hyderhasnain/arduino_touchscreen_controller/Schematic And Design/Eagle Board Unrouted.brd

## EAGLE design Schematic And Design/Eagle Board Unrouted.brd (2014-02-13)

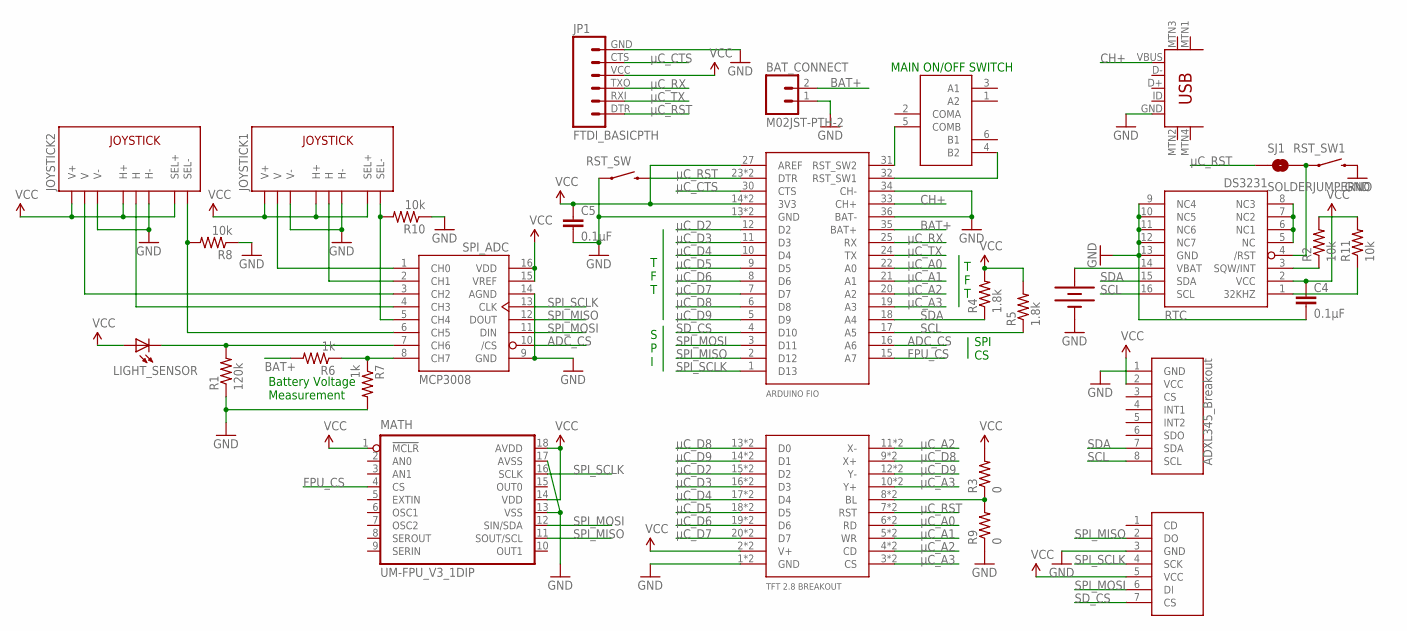
[picture p1: schematic Eagle Schematic.sch]

Parts:
ACCEL1: ADXL345_BREAKOUT; 1X08
BAT1: BATTERY12MM; BATTCON_12MM
BAT_CONNECT: M02JST-PTH-2; JST-2-PTH
C4, C5: 0.1µF; CAP-PTH-SMALL
JOYSTICK1, JOYSTICK2: JOYSTICKPTH; JOYSTICK
JP1: FTDI_BASICPTH; FTDI_BASIC
LIGHT_SENSOR: LED5MM
MATH: UM-FPU_V3_1DIP; DIL18
R1: 120k; AXIAL-0.4
R2, R8, R10, R11: 10k; AXIAL-0.4
R3, R9: 0; AXIAL-0.4
R4, R5: 1.8k; AXIAL-0.4
R6, R7: 1k; AXIAL-0.4
RST_SW, RST_SW1: SWITCH-MOMENTARY-2PTH; TACTILE-PTH
RTC: DS3231/SO; SO16W
SJ1: SOLDERJUMPERNO; SJ_2S-NO
SPI_ADC: MCP3008; DIL16
U$1: ARDUINOFIO
U$2: TFT2.8BREAKOUT
U$3: RIGHTANGLE_DPDT_PTH
U$4: MICROSD_BREAKOUT
USB_CHARGE: USB-MINIB-5PIN; USB-MINIB

Connections:
ADC_CS: SPI_ADC.10 (/CS), U$1.16 (A6)
BAT+: BAT_CONNECT.2, R6.P$2 (2), U$1.35 (BAT+)
CH+: U$1.33 (CH+), USB_CHARGE.VBUS
FPU_CS: MATH.4 (CS), U$1.15 (A7)
GND: ACCEL1.1 (GND), BAT1.GND (-), BAT_CONNECT.1, C4.2, C5.2, JOYSTICK1.H3 (H-), JOYSTICK1.V3 (V-), JOYSTICK2.H3 (H-), JOYSTICK2.V3 (V-), JP1.GND (6), MATH.13 (VSS), MATH.17 (AVSS), R1.P$1 (1), R7.P$2 (2), R8.P$1 (1), R9.P$1 (1), R10.P$1 (1), RST_SW.1, RST_SW1.3 (2), RTC.9 (NC4), RTC.10 (NC5), RTC.11 (NC6), RTC.12 (NC7), RTC.13 (GND), SPI_ADC.9 (GND), SPI_ADC.14 (AGND), U$1.13 (GND), U$1.28 (GND), U$1.34 (CH-), U$1.36 (BAT-), U$2.1 (GND), U$2.21 (GND), U$4.3 (GND), USB_CHARGE.GND
unnamed: JOYSTICK1.B2A (SEL-), R10.P$2 (2), SPI_ADC.5 (CH4)
unnamed: JOYSTICK2.B2A (SEL-), R8.P$2 (2), SPI_ADC.6 (CH5)
unnamed: LIGHT_SENSOR.K (C), R1.P$2 (2), SPI_ADC.7 (CH6)
unnamed: U$1.31 (RST_SW2), U$3.5 (COMB)
unnamed: U$1.32 (RST_SW1), U$3.4 (B2)
unnamed: RST_SW1.1, RTC.4 (/RST), SJ1.2
unnamed: R3.P$1 (1), R9.P$2 (2), U$2.8 (BL), U$2.34 (BL)
unnamed: R6.P$1 (1), R7.P$1 (1), SPI_ADC.8 (CH7)
unnamed: BAT1.PWR@1 (+), RTC.14 (VBAT)
unnamed: R2.P$1 (1), RTC.3 (SQW/INT)
unnamed: R11.P$1 (1), RTC.1 (32KHZ)
unnamed: R2.P$2 (2), R11.P$2 (2)
unnamed: JOYSTICK1.V2 (V), SPI_ADC.1 (CH0)
unnamed: JOYSTICK1.H2 (H), SPI_ADC.2 (CH1)
unnamed: JOYSTICK2.V2 (V), SPI_ADC.3 (CH2)
unnamed: JOYSTICK2.H2 (H), SPI_ADC.4 (CH3)
unnamed: RTC.5 (NC), RTC.6 (NC1), RTC.7 (NC2), RTC.8 (NC3)
SCL: ACCEL1.8 (SCL), R5.P$1 (1), RTC.16 (SCL), U$1.17 (A5)
SDA: ACCEL1.7 (SDA), R4.P$1 (1), RTC.15 (SDA), U$1.18 (A4)
SD_CS: U$1.4 (D10), U$4.7 (CS)
SPI_MISO: MATH.11 (SOUT/SCL), SPI_ADC.12 (DOUT), U$1.2 (D12), U$4.2 (DO)
SPI_MOSI: MATH.12 (SIN/SDA), SPI_ADC.11 (DIN), U$1.3 (D11), U$4.6 (DI)
SPI_SCLK: MATH.16 (SCLK), SPI_ADC.13 (CLK), U$1.1 (D13), U$4.4 (SCK)
VCC: ACCEL1.2 (VCC), C4.1, C5.1, JOYSTICK1.B1A (SEL+), JOYSTICK1.H1 (H+), JOYSTICK1.V1 (V+), JOYSTICK2.B1A (SEL+), JOYSTICK2.H1 (H+), JOYSTICK2.V1 (V+), JP1.VCC (4), LIGHT_SENSOR.A, MATH.1 (!MCLR), MATH.14 (VDD), MATH.18 (AVDD), R3.P$2 (2), R4.P$2 (2), R5.P$2 (2), RTC.2 (VCC), SPI_ADC.15 (VREF), SPI_ADC.16 (VDD), U$1.14 (3V3), U$1.26 (3V3), U$1.27 (AREF), U$2.2 (V+), U$2.31 (V+), U$4.5 (VCC)
µC_A0: U$1.22 (A0), U$2.6 (RD), U$2.33 (RD)
µC_A1: U$1.21 (A1), U$2.5 (WR), U$2.23 (WR)
µC_A2: U$1.20 (A2), U$2.4 (CD), U$2.11 (X-), U$2.26 (X-), U$2.32 (CD)
µC_A3: U$1.19 (A3), U$2.3 (CS), U$2.10 (Y+), U$2.22 (CS), U$2.35 (Y+)
µC_CTS: JP1.CTS (5), U$1.30 (CTS)
µC_D2: U$1.12 (D2), U$2.15 (D2), U$2.28 (D2)
µC_D3: U$1.11 (D3), U$2.16 (D3), U$2.38 (D3)
µC_D4: U$1.10 (D4), U$2.17 (D4), U$2.29 (D4)
µC_D5: U$1.9 (D5), U$2.18 (D5), U$2.39 (D5)
µC_D6: U$1.8 (D6), U$2.19 (D6), U$2.30 (D6)
µC_D7: U$1.7 (D7), U$2.20 (D7), U$2.40 (D7)
µC_D8: U$1.6 (D8), U$2.9 (X+), U$2.13 (D0), U$2.25 (X+), U$2.27 (D0)
µC_D9: U$1.5 (D9), U$2.12 (Y-), U$2.14 (D1), U$2.36 (Y-), U$2.37 (D1)
µC_RST: JP1.DTR (1), RST_SW.3 (2), SJ1.1, U$1.23 (DTR), U$1.29 (DTR), U$2.7 (RST), U$2.24 (RST)
µC_RX: JP1.TXO (3), U$1.25 (RX)
µC_TX: JP1.RXI (2), U$1.24 (TX)

Notes on the sheet:
T F T
S P I
SPI CS
Battery Voltage Measurement
MAIN ON/OFF SWITCH

Board: 2 copper layers, 31 parts (0 on the bottom side), 45 nets, no tracks yet.
