hyderhasnain/arduino_touchscreen_controller/(commit log)

2014-02-13 Added Eagle and Diptrace files
    Note: Eagle BRD file isn't routed at all. I routed the board in Diptrace
    [2013 Touchscreen Controller 1.brd, 2013 Touchscreen Controller 1.sch, 2013 Touchscreen Controller Ground Test 2.dip]
2014-02-13 Added Eagle and Diptrace schematic/pcb files
    Note: Eagle PCB file not routed, wasn't used other than to export into
    Diptrace.
    [Eagle Board Unrouted.brd, Eagle Schematic.sch]
